mengstr/AppleII-VGA100/README.md

# Apple II VGA Card 100mm PCB

This is a smaller (fits within a 100x100 mm PCB) version of the PCB for the Apple II VGA card. The
original project with the firmware and instructions is located at https://github.com/markadev/AppleII-VGA
