mengstr/AppleII-VGA100/(notices)

Notices in the files:
AppleVGA100.kicad_pcb:
Licensed under CERN-OHL-P V2.0 (https://ohwr.org/cern_ohl_p_v2.txt)
Copyright (c) 2021-2023 Mark Aikens
